Akinfoluhan/automated-smart-barrier-gate-system/docs/project_poster.jpeg

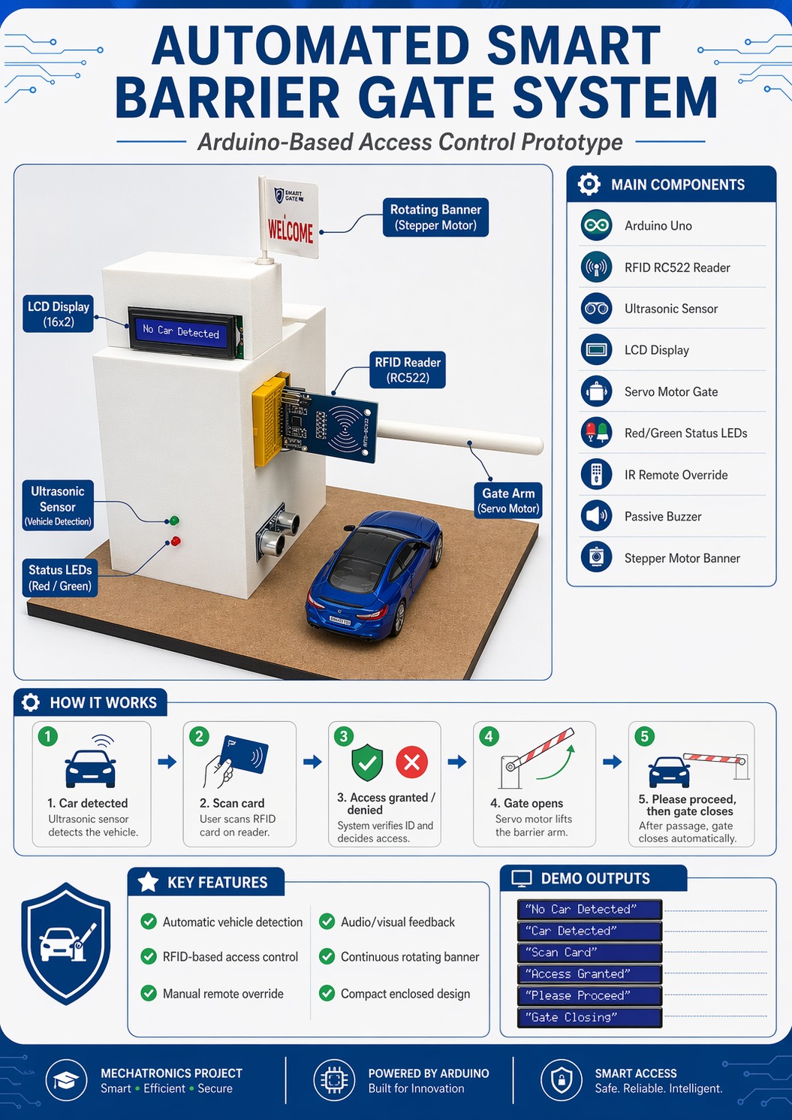
docs/project_poster.jpeg
