Akinfoluhan/automated-smart-barrier-gate-system/media/photos/top_view.jpg

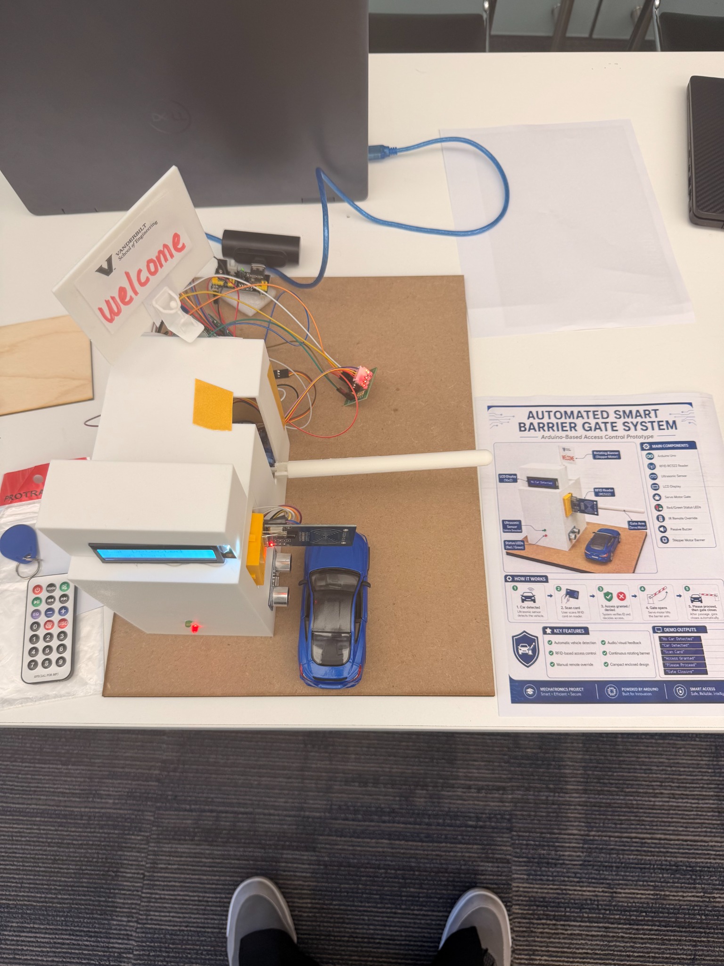
media/photos/top_view.jpg
