Akinfoluhan/automated-smart-barrier-gate-system/media/video/demo-preview.jpg

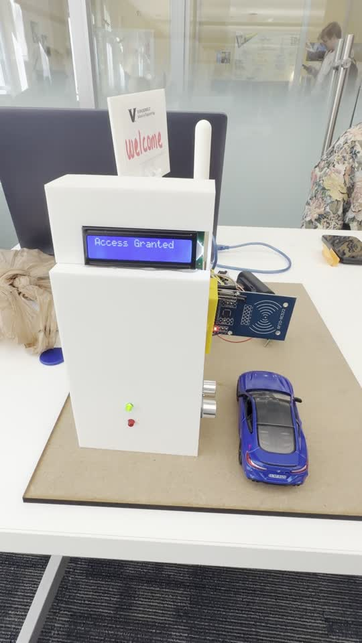
media/video/demo-preview.jpg
