Akinfoluhan/automated-smart-barrier-gate-system/hardware/solidworks/main_structure.SLDPRT

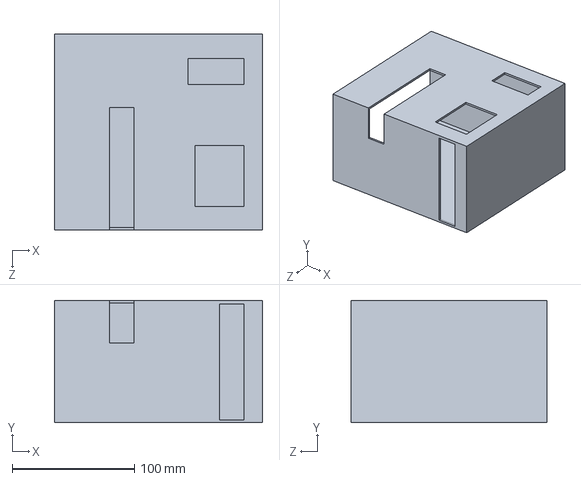
[picture p12: CAD file, 2026-10-17]
hardware/solidworks/main_structure.SLDPRT
170.0 x 100.0 x 160.0 mm
