Akinfoluhan/automated-smart-barrier-gate-system/hardware/solidworks/display_cover.SLDPRT

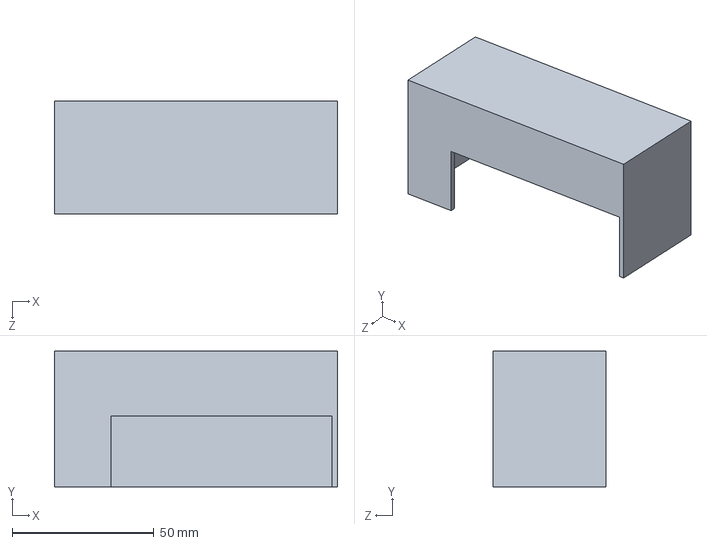
[picture p13: CAD file, 2026-10-17]
hardware/solidworks/display_cover.SLDPRT
100.0 x 48.0 x 40.0 mm
