Akinfoluhan/automated-smart-barrier-gate-system/hardware/solidworks/back_cover.SLDPRT

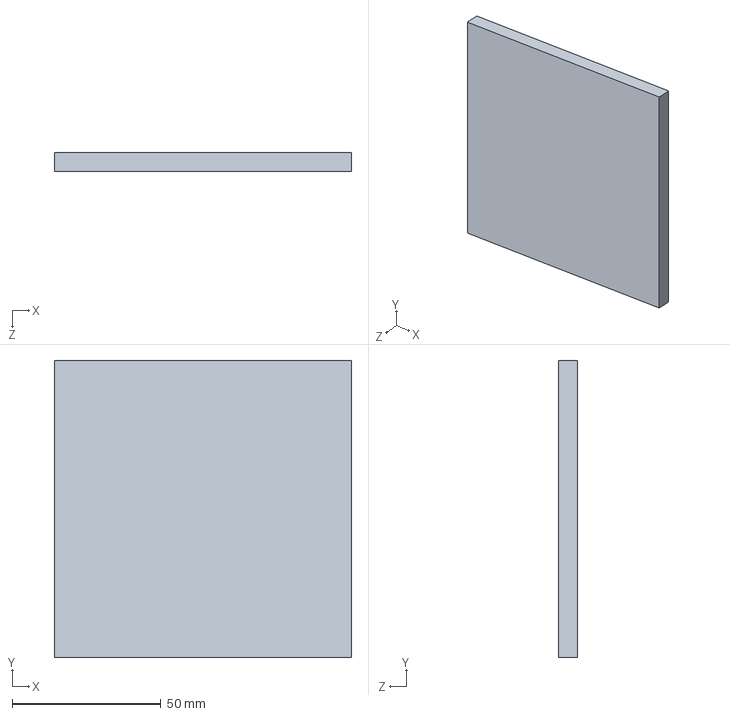
[picture p14: CAD file, 2026-10-17]
hardware/solidworks/back_cover.SLDPRT
100.0 x 100.0 x 6.35 mm
