Akinfoluhan/automated-smart-barrier-gate-system/hardware/solidworks/base_plate.SLDPRT

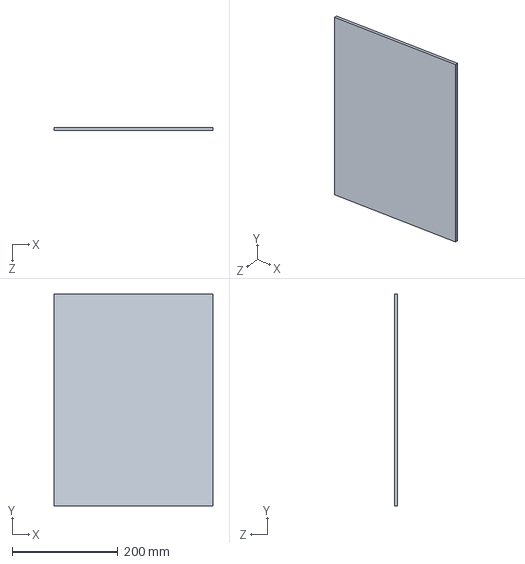
[picture p15: CAD file, 2026-10-17]
hardware/solidworks/base_plate.SLDPRT
300.0 x 400.0 x 6.35 mm
