Akinfoluhan/automated-smart-barrier-gate-system/hardware/solidworks/road_platform.SLDPRT

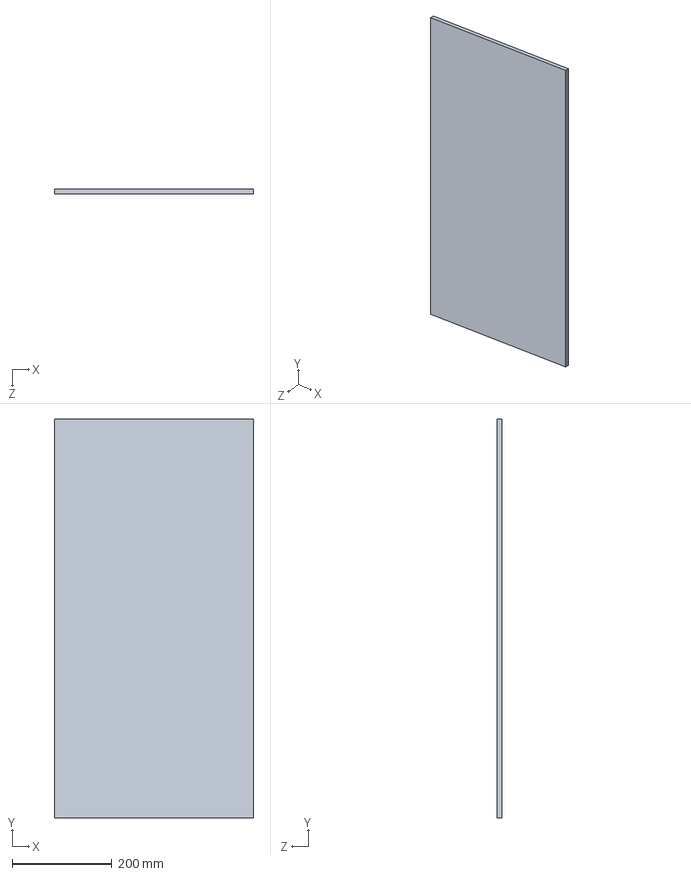
[picture p16: CAD file, 2026-10-17]
hardware/solidworks/road_platform.SLDPRT
400.0 x 800.0 x 10.0 mm
