Akinfoluhan/automated-smart-barrier-gate-system/(commit log)

2026-10-17 feat: add Arduino gate controller and subsystem tests
2026-10-17 docs: clean up Arduino comments and sample RFID configuration
2026-10-17 feat: add SolidWorks enclosure designs and CAD renders
    [back_cover.SLDPRT, base_plate.SLDPRT, display_cover.SLDPRT, main_structure.SLDPRT, road_platform.SLDPRT]
2026-10-17 docs: add technical report, prototype photos, and demo video
2026-10-17 docs: clarify prototype testing and firmware setup
2026-10-17 docs: resize prototype images in README
